denis-bisson/BirdPool2022/README.md

# BirdPool2022
Little "C" complete program to dump in a Microchip PIC18F1330 to control water valve for a bird bath.

Basically there is like a water fountain and birds like to take a bath there. 
Unfortunately, as they keep playing in the water, the water are throw outside and ultimately the bath is missing water. 
The little projet is to have an electric valve control by a little PIC18F1330 to control that valve to add water when necessary. 
There are two level switches for the water to help to determine when we are missing water and when we added enough.
More details to be added later.

# Timeline 
2021-12-27 @ 22:00:00 - Ordered the few parts I don't have in inventory at home like the relay, the terminal blocks and the blue diode. 
2021-12-27 @ 22:00:01 - Played a little with the 3D board preview. 
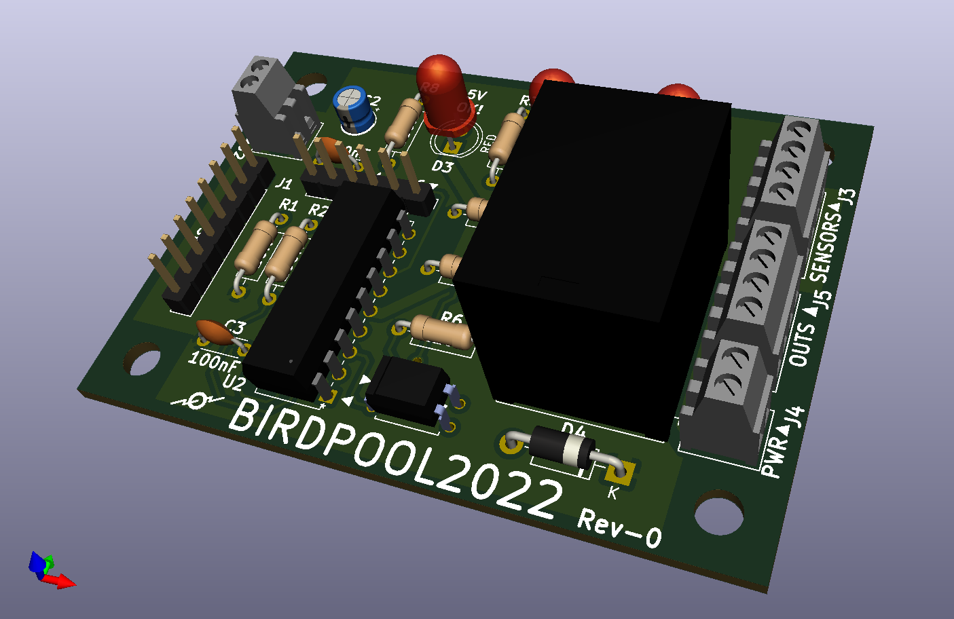
[picture p1: images/2021-12-27@21-59-00_3D_Preview.png]


2021-12-26 @ 16:47:00 - Ordered three PCB prototypes from [OSH PARK](https://oshpark.com/).
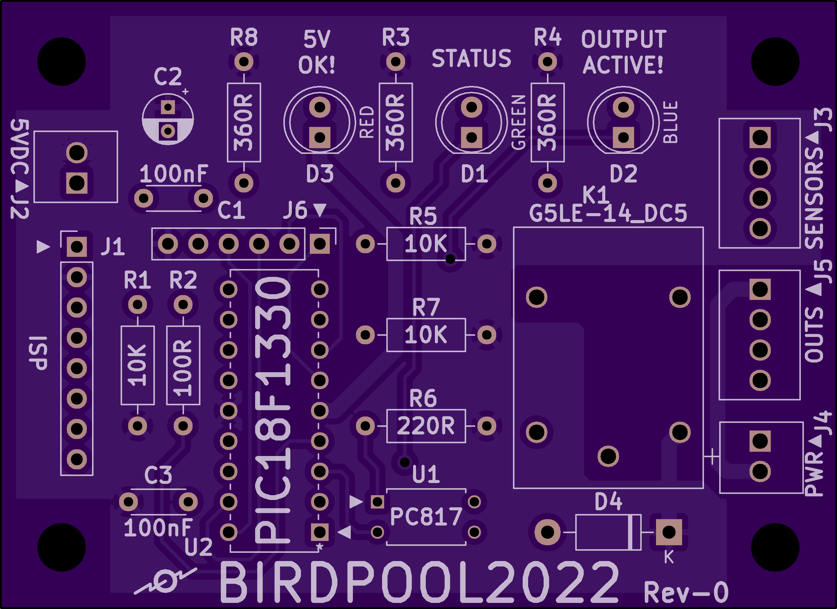
[picture p2: images/2021-12-26@16-36-00-0ac8ea9d5f799b5375694a8139059e29.png]


2021-12-24 @ 22:35:00 - Begin the schematic and PCB drawings 
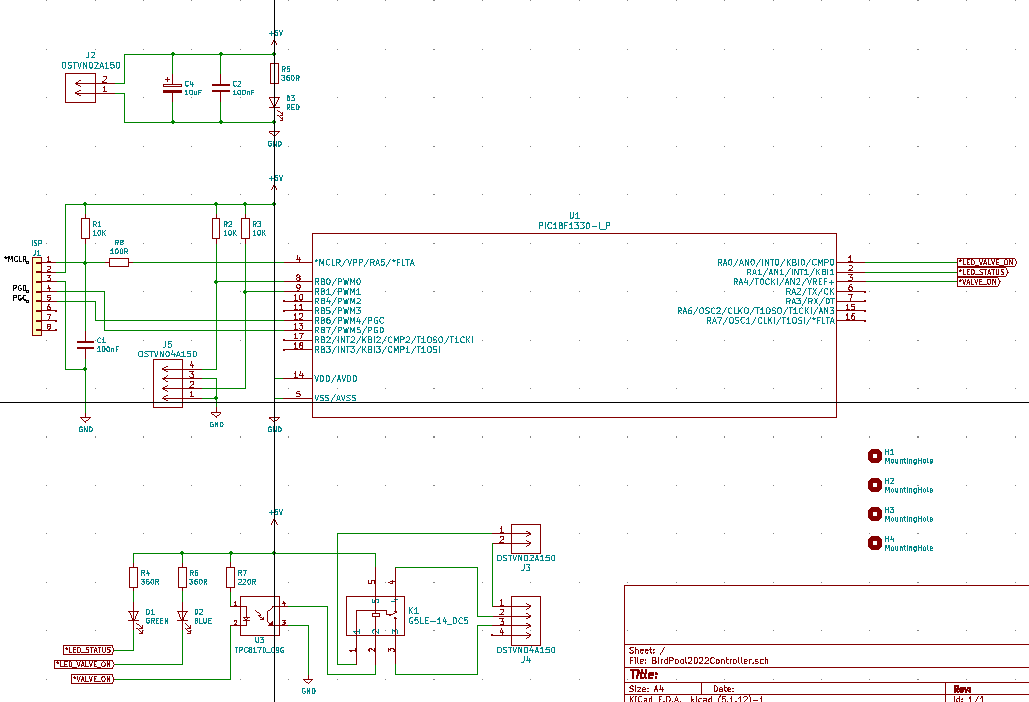
[picture p3: images/2021-12-24@22-34-00_SCH.png]
Schematic

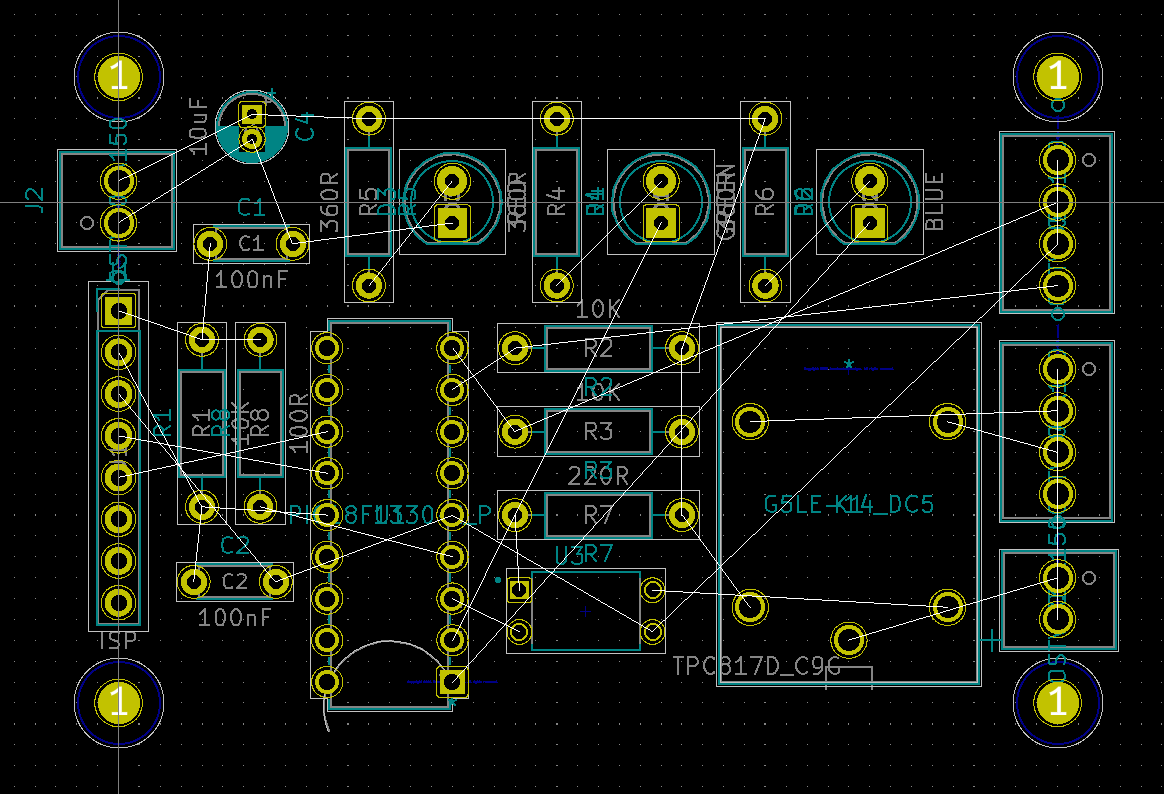
[picture p4: images/2021-12-24@22-34-00_PCB.png]


2021-12-22 @ 22:07:00 - Prototype to test the initial program with a PIC18F1330 
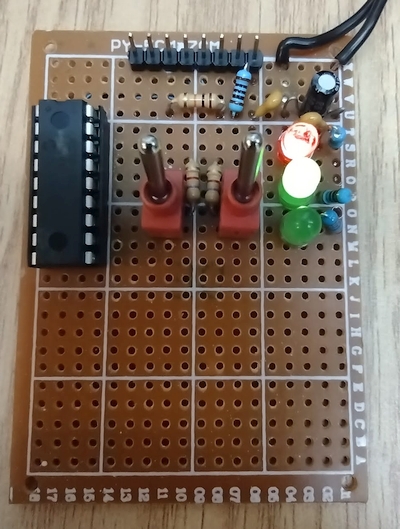
[picture p5: images/2021-12-22@22-09-00_Top.jpg]
Top

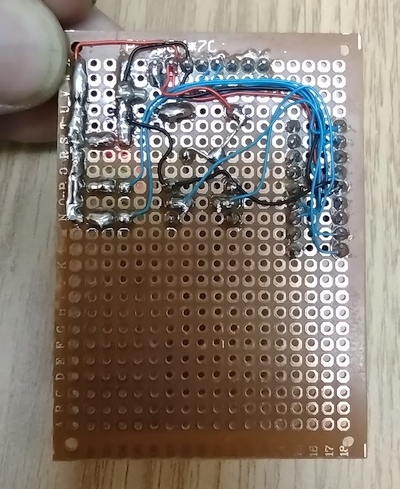
[picture p6: images/2021-12-22@22-09-00_Bottom.jpg]
Bottom

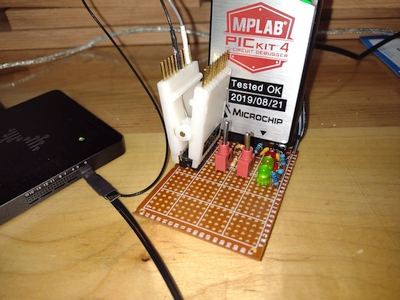
[picture p7: images/2021-12-22@22-09-00_Overview.jpg]
Overview of prototype
