denis-bisson/BirdPool2022/doc/ReadMe.txt

2022-01-08:DB
  -The inspiration form where is coming the circuit to control the 24V valve is here: https://rayshobby.net/wordpress/minty-water-valve-controller/
