denis-bisson/BirdPool2022/doc/2022-01-08 - Inspiration.png

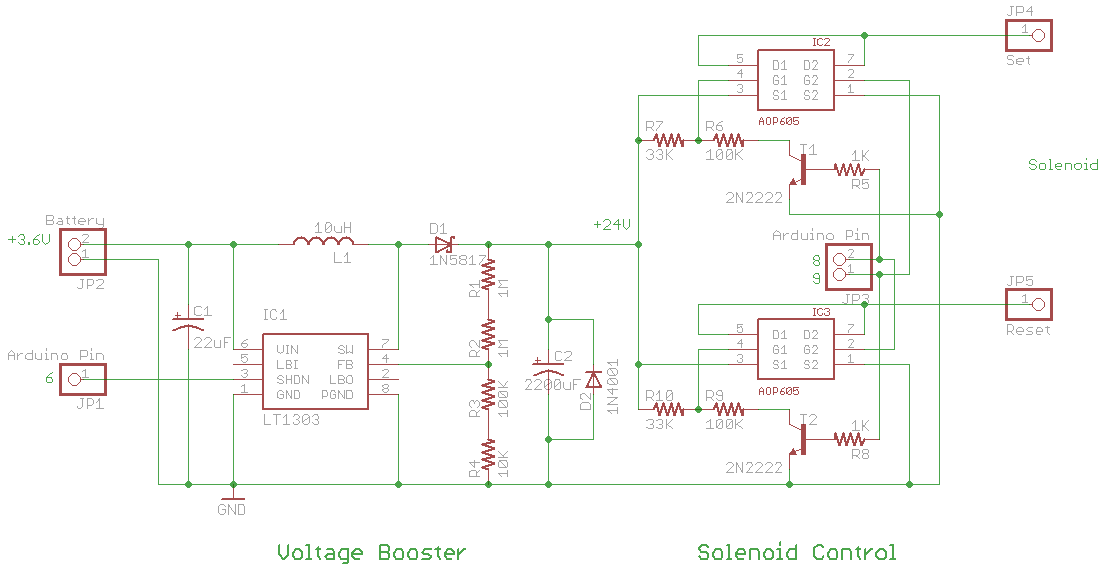
doc/2022-01-08 - Inspiration.png
