denis-bisson/BirdPool2022/board/Rev-0/BirdPool2022Controller.kicad_pcb

## KiCad design board/Rev-0/BirdPool2022Controller.kicad_pcb (2022-01-03)

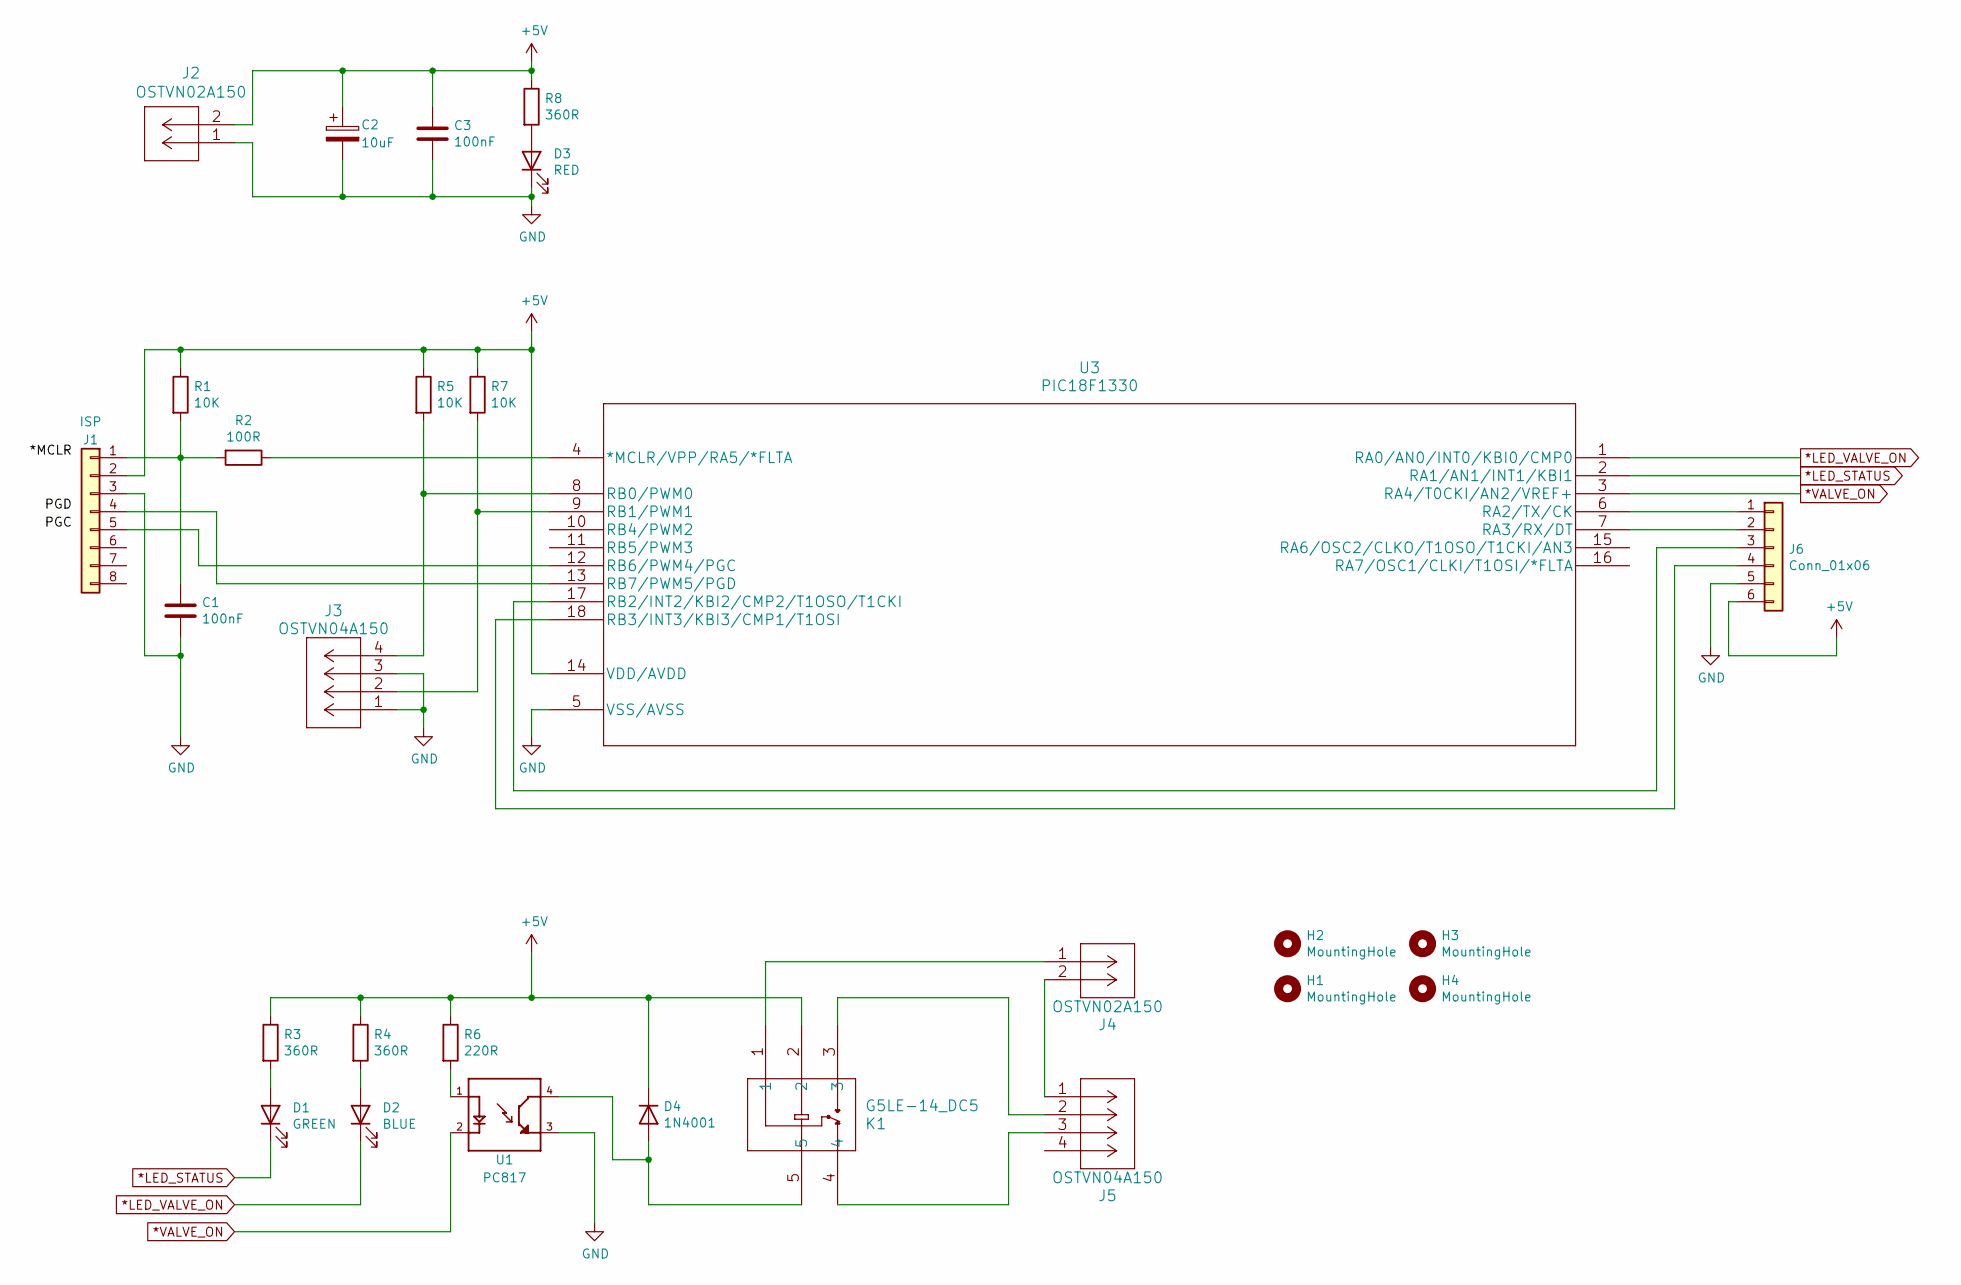
[picture p9: schematic BirdPool2022Controller.kicad_sch]

Parts:
C1, C3: 100nF; C_Disc_D4.3mm_W1.9mm_P5.00mm
C2: 10uF; CP_Radial_D4.0mm_P2.00mm
D1: GREEN; LED_D5.0mm
D2: BLUE; LED_D5.0mm
D3: RED; LED_D5.0mm
D4: 1N4001; D_DO-41_SOD81_P10.16mm_Horizontal
H1, H2, H3, H4: MountingHole; MountingHole_2.5mm
J1: ISP; PinHeader_1x08_P2.54mm_Vertical
J2, J4: OSTVN02A150; CONN_OSTVN02A150_OST
J3, J5: OSTVN04A150; CONN_OSTVN04A150_OST
J6: Conn_01x06; PinHeader_1x06_P2.54mm_Vertical
K1: G5LE-14_DC5; RELAY_G5LE-1_DC5_OMR
R1, R5, R7: 10K; R_Axial_DIN0207_L6.3mm_D2.5mm_P10.16mm_Horizontal
R2: 100R; R_Axial_DIN0207_L6.3mm_D2.5mm_P10.16mm_Horizontal
R3, R4, R8: 360R; R_Axial_DIN0207_L6.3mm_D2.5mm_P10.16mm_Horizontal
R6: 220R; R_Axial_DIN0207_L6.3mm_D2.5mm_P10.16mm_Horizontal
U1: PC817; DIP810W50P254L470H446Q4
U3: PIC18F1330; PDIP18_300MC_MCH

Connections:
*LED_STATUS: D1.1 (K), U3.2 (RA1/AN1/INT1/KBI1)
*LED_VALVE_ON: D2.1 (K), U3.1 (RA0/AN0/INT0/KBI0/CMP0)
*VALVE_ON: U1.2, U3.3 (RA4/T0CKI/AN2/VREF+)
+5V: C2.1, C3.1, D4.1 (K), J1.2, J2.2, J6.6, K1.2, R1.1, R3.1, R4.1, R5.1, R6.1, R7.1, R8.1, U3.14 (VDD/AVDD)
GND: C1.2, C2.2, C3.2, D3.1 (K), J1.3, J2.1, J3.1, J3.3, J6.5, U1.3, U3.5 (VSS/AVSS)
unnamed: C1.1, J1.1, R1.2, R2.2
unnamed: D1.2 (A), R3.2
unnamed: D2.2 (A), R4.2
unnamed: D3.2 (A), R8.2
unnamed: D4.2 (A), K1.5, U1.4
unnamed: J1.4, U3.13 (RB7/PWM5/PGD)
unnamed: J1.5, U3.12 (RB6/PWM4/PGC)
unnamed: J3.2, R7.2, U3.9 (RB1/PWM1)
unnamed: J3.4, R5.2, U3.8 (RB0/PWM0)
unnamed: J4.1, K1.1
unnamed: J4.2, J5.1
unnamed: J5.2, K1.3
unnamed: J5.3, K1.4
unnamed: J6.1, U3.6 (RA2/TX/CK)
unnamed: J6.2, U3.7 (RA3/RX/DT)
unnamed: J6.3, U3.17 (RB2/INT2/KBI2/CMP2/T1OSO/T1CKI)
unnamed: J6.4, U3.18 (RB3/INT3/KBI3/CMP1/T1OSI)
unnamed: R2.1, U3.4 (*MCLR/VPP/RA5/*FLTA)
unnamed: R6.2, U1.1

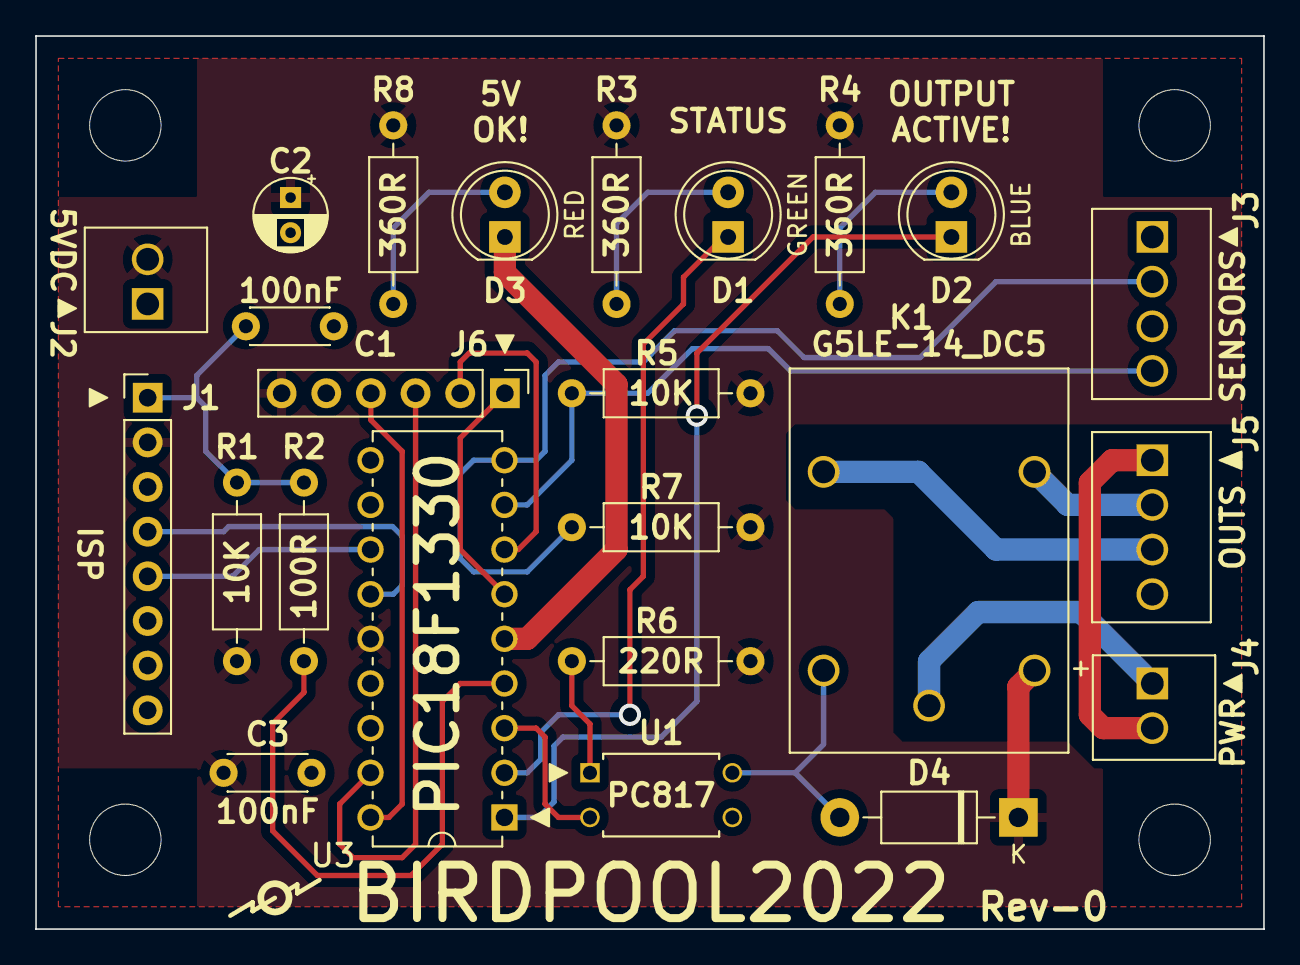
[picture p10: board BirdPool2022Controller.kicad_pcb from above]

Board: 2 copper layers, 69.8 x 50.8 mm, 28 parts (0 on the bottom side), 24 nets.
