denis-bisson/BirdPool2022/(commit log)

2021-12-23 First commmit
    ADD: Source added. Slowly began prototype.
2021-12-25 ADD: Start the schematic and the PCB
    ADD: Schematic and PCB file added. I am trying KiCad.
    [BirdPool2022Controller.kicad_pcb, BirdPool2022Controller.sch]
2021-12-25 ADD: New images added to timeline
    Essentially, these are screen capture of the schematic and PCB drawing
2021-12-25 ADD: Board routed
    ADD: Board has been routed.
    FIX: The relay has been routed with inverted connexion for the coil. This has been fixed.
    ADD: 6-pins expansion connector has been added.
    [BirdPool2022Controller.kicad_pcb, BirdPool2022Controller.sch]
2021-12-26 FIX: Arrange PCB
    ADD: Keepout area around mounting hole.
    ADD: Keepout area added around relay related traces.
    ADD: Use copper pour for both ground and power traces.
    [BirdPool2022Controller.kicad_pcb, BirdPool2022Controller.sch]
2021-12-26 Store board files in revision number directory
    [BirdPool2022Controller.kicad_pcb]
2021-12-26 Correction around the relay
    ADD: In code, add control of RA4 for the relay for the valve.
    ADD: In PCB, add fly wheel diode.
    CHG: Rearrange the relay area since the fly wheel diode addition.
    [BirdPool2022Controller.kicad_pcb, BirdPool2022Controller.sch]
2021-12-26 PCB ordered!
    ADD: Official Gerber file generated for the Rev-0.
    ADD: Three prototypes ordered from OSH PARKS.
    ADD: Picture of the preview of the PCB.
    [BirdPool2022Controller.kicad_pcb]
2021-12-28 Played with the 3D preview generation
    [BirdPool2022Controller.kicad_pcb]
2022-01-03 UPD: Boards now with KiCad 6.0.0
    [BirdPool2022Controller.kicad_pcb, BirdPool2022Controller.kicad_sch, BirdPool2022Controller.sch]
2022-01-03 FIX: The 3D model for the board is now correct.
    [BirdPool2022Controller.kicad_pcb]
2022-01-08 Progression of Rev-A board
    -To be able to use a more available valves, the revision A circuit is slowly coming in place. We need to generate 24V from the 5V, and also being able to control the polarity of the applied 24V.
    -Schematics made with KiCad 6.0.0.
    [BirdPool2022 Rev-A.kicad_pcb, BirdPool2022 Rev-A.kicad_sch, BirdPool2022Controller.kicad_sch]
2022-01-08 Add a note for Rev-0 board
    -Add the following note for the Rev-0 board: "PC817 is not efficient enough for current required for the relay. I used instead of Darlington one, the PS2533-1-V-A. Digi-Key 559-1255-ND>.
    [BirdPool2022Controller.kicad_sch]
2022-01-08 ADD: Inspiration
    -The inspiration for the 24V control circuit source has been added.
